mblsha/retrobus-explorer/README.md

# RetroBus Explorer

RetroBus Explorer is an FPGA-based platform designed to capture, analyze, and
visualize signals from legacy 5V system buses. It uses a specialized
level-shifting interface board for bus compatibility, streams the captured data
through an FT600 FTDI chip, and presents live waveforms, decoded protocols, and
analytics via a Marimo Notebook interface in the browser.

## Start here: Sharp organizer cards

- **Dump a card or program its SRAM:** [card dumper and SRAM programmer](gateware/projects/sharp-organizer-probe/README.md#quick-start).
- **Emulate a card and run native IQ-7000/OZ experiments:** [ROM/SRAM2 emulator and eval-loop quick start](gateware/projects/sharp-organizer-emulator/README.md#quick-start), with UART control and bidirectional FT600 streaming.
- **Observe an organizer's bus:** [passive organizer monitor](gateware/projects/sharp-organizer-card/README.md).

See [Choose an organizer tool](gateware/README.md#choose-an-organizer-tool) for
the fixture and bus role of each project. The emulator's
[qualification record](gateware/projects/sharp-organizer-emulator/QUALIFICATION.md)
separates verified simulation/build results from pending organizer tests.

# Current Status

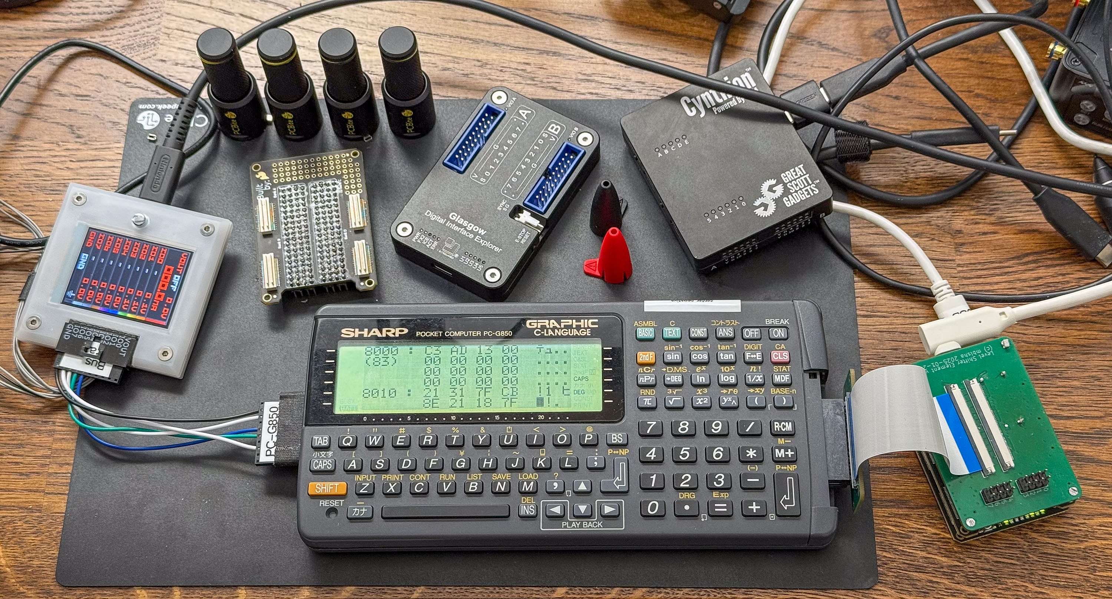
[picture p1: _images/pc-g850.jpg]
SHARP PC-G850 with both its UART and System Bus connected to a computer


* SHARP PC-G850 (Z80-based)

    **Bus Decoding**: Works

    **Visualization**:

     * SED1560 LCD controller: Basic functionality works
     * Key Matrix: Works (decodes key scanning with IO ports)

    **ROM Decoding**: In Progress ([Binary Ninja
    Plugin](https://github.com/mblsha/Z80/blob/master/SharpPCG850View.py))

    **External ROM Emulation**: Can stream data in ext banks 0 and 1 from USB3
    continuously, this could be used for video playback

* SHARP IQ-7000 (SC62015-based)

    **ROM Decoding**: In Progress ([Binary Ninja
    Plugin](https://github.com/mblsha/binja-esr))

    **Card Emulation / Native Eval Loop**: [Spade implementation with UART and FT600](gateware/projects/sharp-organizer-emulator/README.md#quick-start); organizer launch and electrical timing await qualification. Intended for the IQ-7000-style bus and OZ family, including OZ-9600 experiments.

# Sharp organizer card dumping and SRAM programming

With the Alchitry Au1, Level Shifter Element, and Sharp Organizer Host Adapter,
RetroBus Explorer can dump card ROM and SRAM, deduplicate identical data while
preserving each tested pin selection, and write confirmed SRAM banks.
`capture-card` commits the current backup to a Git archive before reversible
SRAM presence probes; `write-sram` checks that backup and verifies the write.
The CLI automatically releases the bus when an operation ends.

Start with the [card dumper and SRAM programmer quick start](gateware/projects/sharp-organizer-probe/README.md#quick-start)
for hardware requirements, capture commands, archive storage, and SRAM writes.
The archive location is supplied by the caller with `--archive-dir`.

# Sharp organizer native execution card

The [native execution card quick start](gateware/projects/sharp-organizer-emulator/README.md#quick-start)
provides a resident eval loop, UART-loaded code and SRAM2 scratch memory,
live bus timing controls, and bidirectional FT600 bus traces and host-fed data.
Simulation and nextpnr builds are verified; organizer boot entry still needs
hardware qualification. See the [CLI command reference](gateware/projects/sharp-organizer-emulator/README.md#cli-command-reference)
for image loading, native jobs, SRAM2 access, timing, capture, and explicit disarm.

# Hardware

Project is built on top of [Alchitry Au FPGA board](https://www.sparkfun.com/alchitry-au-fpga-development-board-xilinx-artix-7.html) and [Ft Element board](https://www.sparkfun.com/alchitry-ft-element-board.html).
To interface with the 5V bus, a Level Shifter Element board is used.

For streaming capture projects such as the SHARP PC-G850 bus monitor and the
SHARP PC-E500 card monitor, the expected host data path is the Alchitry Ft
Element USB3 FIFO interface (FT600-class device) driven through the repository's
`py/d3xx` wrapper. The Au board's onboard USB-UART remains the control/console
path and is not the expected bulk capture interface.

Hardware adapters connect the Level Shifter Element board to the target system.
Up to 48 signals can be captured simultaneously.

Up to two adapters can be connected at the same time, allowing to capture
communication on the system bus and the external bus card.

# Hardware Adapters (up to 48 signals)

* [Level Shifter Element Au1](https://github.com/mblsha/retrobus-explorer/blob/master/jitx/alchitry-au1-level-shifter.stanza)
* [Pin Tester](https://github.com/mblsha/retrobus-explorer/blob/master/jitx/pin-tester.stanza) to test correctness and signal integrity
* [SHARP PC-G850 Bus Connector](https://github.com/mblsha/retrobus-explorer/blob/master/jitx/sharp-pc-g850-bus.stanza)
* [SHARP PC-E500 RAM Card](https://github.com/mblsha/retrobus-explorer/blob/master/jitx/sharp-pc-e500-ram-card.stanza)
* [SHARP Organizer Card](https://github.com/mblsha/retrobus-explorer/blob/master/jitx/sharp-organizer-card.stanza) (plugs into organizers)
* [SHARP Organizer Host](https://github.com/mblsha/retrobus-explorer/blob/master/jitx/sharp-organizer-host.stanza) (accepts card connections)
* [SC62015 CPU Interposer](https://github.com/mblsha/retrobus-explorer/blob/master/jitx/sharp-sc62015-interposer.stanza)
* [SC61860 CPU Interposer](https://github.com/mblsha/retrobus-explorer/blob/master/jitx/sharp-sc61860-interposer.stanza)

# Misc Adapters

* [RPi 40-pin to RPi Pico](https://github.com/mblsha/retrobus-explorer/blob/master/jitx/rpi-pico-40-pin-adapter.stanza)
* [Saleae to DSLab probes](https://github.com/mblsha/retrobus-explorer/blob/master/jitx/saleae-dslab-adapter.stanza)

# Building FPGA Projects

The active FPGA gateware is written in Spade and lives in the `gateware/` uv
workspace. Swim compiles each project to SystemVerilog; Cocotb and Verilator
provide the local behavioral test path.

## Quick Start

```bash
cd gateware

# First-time Python/testbench setup
uv sync --locked --all-packages

# Validate the registered workspace and run a project testbench
uv run python tools/project_inventory.py --check
uv run python tools/run_tb.py --project projects/pin-tester
```

See the [gateware guide](gateware/README.md) for the project layout, shared
components, waveform generation, constraint handling, synthesis, and flashing.

# License

* PCB Design Files
All PCB design files are distributed under the
`CERN Open Hardware Licence Version 2 – Permissive`.

* Software (HDL, JS, etc.)
Other than the d3xx Python code all other repository contents—including FPGA
gateware (HDL), and Python code are released under the `Apache License 2.0`.

You are free to use, modify, and distribute both portions of this project under
their respective terms.

# Alternatives

* [LAIR](https://github.com/MustBeArt/LAIR) project shows how to decode Z80
    bus using a hardware adapter with propagation delays that connects to a
    136-channel HP Agilent 1670G logic analyzer.

# USB Device Info

* Alchitry Au

  Product ID: 0x6010
  Vendor ID:  0x0403  (Future Technology Devices International Limited)

* Alchitry Ft

  Name: FTDI SuperSpeed-FIFO Bridge
  Product ID: 0x601e
  Vendor ID:  0x0403  (Future Technology Devices International Limited)

# Thanks

A big thank you (in alphabetical order) to Louis, Nikolai, and
[Peter](https://taricorp.net) for teaching me the dark magic of hardware and
low-level development, as well as for patiently answering my countless
questions. This project would not exist without your help.
