mblsha/retrobus-explorer/py/d3xx/README.md

This version has minor changes to find the dynamic d3xx library.

Requires https://ftdichip.com/drivers/d3xx-drivers/ to be located in this
directory.

## Organizer emulator streaming

The [Sharp organizer ROM/SRAM2 emulator](../../gateware/projects/sharp-organizer-emulator/README.md#ft600-capture-and-host-fed-streams)
uses these bindings for buffered bus capture and concurrent host-to-FPGA data.
Its guide covers exact device selection, binary capture, offline decoding,
receive backpressure, and throughput limits. UART carries emulator control.

# License

This software is provided by Future Technology Devices International Limited “as
is” and any express or implied warranties, including, but not limited to, the
implied warranties of merchantability and fitness for a particular purpose are
disclaimed. In no event shall future technology devices international limited be
liable for any direct, indirect, incidental, special, exemplary, or
consequential damages (including, but not limited to, procurement of substitute
goods or services; loss of use, data, or profits; or business interruption)
however caused and on any theory of liability, whether in contract, strict
liability, or tort (including negligence or otherwise) arising in any way out of
the use of this software, even if advised of the possibility of such damage.
