mblsha/retrobus-explorer/jitx-py/sharp-sc61860-interposer/README.md

# sharp-sc61860-interposer

Python JITX port scaffold for the SHARP SC61860 interposer board.

This is a thin two-layer polyimide flex PCB using the shared JLCPCB 0.11 mm FPC process defaults.
