mblsha/retrobus-explorer/jitx-py/sharp-sc62015-interposer/README.md

# sharp-sc62015-interposer

Python JITX port scaffold for the SHARP SC62015 interposer board.

This is a thin two-layer polyimide flex PCB using the shared JLCPCB 0.11 mm FPC process defaults.
