mblsha/retrobus-explorer/jitx-py/alchitry-au1-level-shifter/README.md

# alchitry-au1-level-shifter

Python JITX port scaffold for the Alchitry Au1 level shifter board.
