mblsha/retrobus-explorer/jitx-py/sharp-organizer-host/README.md

# sharp-organizer-host-py

Python JITX port scaffold for the retrobus `sharp-organizer-host` board.
