mblsha/retrobus-explorer/gateware/projects/sharp-pc-e500-card/FPGA_PROTOCOL.md

# PC-E500 FPGA Protocol Reference

This document describes the PC-E500 card FPGA control surface:

- USB-UART commands exposed by the FPGA
- Special CE6 control-page registers handled by the FPGA
- Saleae debug and bus-capture streams
- FT600 bulk capture of sampled-bus words
- Response formats and practical examples

All timings below assume the current `100 MHz` FPGA clock.

## Overview

The design exposes two separate control paths:

- USB-UART command parser
  - direct host control for RAM, ROM, timing, and measurement dump
- CE6 special control page
  - calculator-visible write-only registers in the CE6 card-ROM region

Optional bulk capture is exposed separately:

- FT600 sampled-bus stream
  - exact mirror of the `saleae[4]` sampled-bus words
  - enabled by CE6 control-page configuration
  - active whenever any enabled FT source is active
  - current sources:
    - measurement window
    - USB-UART latch

Normal CE1 RAM and CE6 ROM timing uses the shared `tNN` delay.
CE6 control-page writes use the separate `cNN` delay.

## Saleae Debug Streams

The Saleae header exposes raw bus pins plus several FPGA-generated debug streams.

Current line map:

| Line | Signal | Meaning |
| --- | --- | --- |
| `saleae[0]` | `ce1` | raw CE1 pin |
| `saleae[1]` | `ce6` | raw CE6 pin, active low |
| `saleae[2]` | `rw` | raw R/W pin |
| `saleae[3]` | event stream | compact CE event stream |
| `saleae[4]` | sampled bus stream | late-sampled address/data/status stream |
| `saleae[5]` | address pulse | debounced internal address-change pulse |
| `saleae[6]` | data UART | settled data-change stream |
| `saleae[7]` | address UART | settled address-change stream |

### Framing

The Saleae UART-like streams are not the same as the `1,000,000 baud` USB-UART.

- `saleae[3]`, `saleae[4]`, `saleae[6]`, and `saleae[7]` run at `100,000,000 baud`
- FPGA clock is `100 MHz`, so one serial bit lasts one FPGA cycle = `10 ns`
- framing is:
  - `1` start bit, low
  - `N` data bits, `LSB` first
  - `1` stop bit, high
  - no parity

Important decode rule:

- do not decode these as ordinary `8N1` bytes unless the payload width is actually `8`
- `saleae[3]` is one `16`-bit frame
- `saleae[4]` is one `32`-bit frame
- `saleae[6]` is one `8`-bit frame
- `saleae[7]` is one `18`-bit frame

For `saleae[3]` and `saleae[4]`, a single event is one wide UART frame, not a sequence of little-endian bytes.

### `saleae[3]` Event Stream

`saleae[3]` emits one `16`-bit event word per classified CE event:

```text
bits 15:8  event tag
bits  7:0  data byte
```

Tags:

| Tag | Meaning |
| --- | --- |
| `0x52` | CE1 read |
| `0x57` | CE1 write |
| `0x72` | CE6 read |
| `0x77` | CE6 write |

Example:

```text
0x575A
```

means a CE1 write carrying data byte `0x5A`.

### `saleae[4]` Sampled Bus Stream

`saleae[4]` emits one `32`-bit sampled bus word. The sampler fires from either:

- an external `cycle_start` pulse, or
- the internal debounced address-change trigger

After either a real `cycle_start` or an internal address-change trigger seeds a
sample, the FPGA may continue emitting phase-locked synthetic follow-up samples
at the nominal `1310 ns` cycle time even if no new trigger arrives. Follow-ups
stop after the captured phase has timed out, which is currently about `64`
nominal cycles (`~83.8 us`) without a new `cycle_start` or address-change
trigger.

Word layout:

```text
bits 17:0   addr
bits 25:18  data
bits 31:26  status
```

Status bit layout:

| Bit | Name | Meaning |
| --- | --- | --- |
| `0` | `rw` | sampled raw `R/W` pin |
| `1` | `ce1_active` | normalized CE1-active flag |
| `2` | `ce6_active` | normalized CE6-active flag |
| `3` | `synthetic_followup` | `1` if this sample is a phase-locked synthetic follow-up event |
| `4` | `from_cycle_start` | `1` if sample was armed by external `cycle_start` |
| `5` | `ctrl_range` | `1` if CE6 was active and low16 was in `0xFFF0..0xFFFF` |

Decode formulas:

```text
addr   =  word        & 0x3FFFF
data   = (word >> 18) & 0xFF
status = (word >> 26) & 0x3F
```

Example:

```text
word = 0x044311F0
addr = 0x311F0
data = 0x10
status = 0x01
```

`status = 0x01` means:

- `rw = 1`
- `ce1_active = 0`
- `ce6_active = 0`
- `synthetic_followup = 0`
- `from_cycle_start = 0`
- `ctrl_range = 0`

So this sample came from the address-change path, not CE1/CE6-qualified decode, and captured address `0x311F0` with data `0x10`.

### `saleae[5]` Address Pulse

`saleae[5]` is not a UART. It is a one-bit pulse stream that marks the
internal debounced address-change trigger.

Properties:

- it pulses on the first observed address change
- it then waits about `100 ns` before re-arming
- it is useful as a correlation marker for the sampled bus stream on `saleae[4]`
- it is upstream of the settled address UART on `saleae[7]`

## USB-UART Commands

The USB-UART runs at `1,000,000 baud`, `8N1`.

Each command must be terminated by `CR` or `CRLF`.
The FPGA echoes accepted input, then emits a response line.

### RAM Commands

These access the `2 KiB` CE1 RAM backing store.

| Command | Meaning |
| --- | --- |
| `rAAA` | Read RAM offset `0x000..0x7FF` |
| `wAAA=BB` | Write RAM offset `0x000..0x7FF` |

Rules:

- `AAA` is 3 hex digits
- `BB` is 2 hex digits
- RAM is only `2 KiB`, mirrored across the larger CE1 window

Examples:

```text
r123
123=5A
```

```text
w123=5A
OK
```

### ROM Commands

These access the `2 KiB` CE6 ROM backing store.

| Command | Meaning |
| --- | --- |
| `RAAA` | Read ROM offset `0x000..0x7FF` |
| `WAAA=BB` | Write ROM offset `0x000..0x7FF` |

Rules:

- `AAA` is 3 hex digits
- `BB` is 2 hex digits
- This writes the FPGA ROM backing store directly
- Calculator bus writes to CE6 do not program ROM; only `WAAA=BB` does

Examples:

```text
W021=A7
OK
R021
021=A7
```

### Timing Commands

| Command | Meaning | Default |
| --- | --- | --- |
| `tNN` | Set normal CE1/CE6 memory classify delay | `t45` |
| `cNN` | Set CE6 control-page write delay | `c03` |

Rules:

- `NN` is decimal `00..99`
- unit is `10 ns`

Examples:

```text
t45
T=450ns
```

```text
c03
C=030ns
```

What they control:

- `tNN`
  - CE1 RAM read/write classify timing
  - CE6 ROM read classify timing
- `cNN`
  - CE6 control-page writes in low16 `0xFFF0..0xFFFF`

### FT Commands

These control the USB-UART FT source latch and query FT stream state.

| Command | Meaning |
| --- | --- |
| `F0` | clear the USB-UART FT source latch |
| `F1` | set the USB-UART FT source latch |
| `F?` | print FT stream status |

Rules:

- `F0` and `F1` only affect the UART source latch
- FT sampled-bus capture runs when any enabled FT source is active
- the USB-UART source only contributes to capture if `FT_STREAM_CFG.bit1 = 1`
- if the UART source is cleared or disabled, the current UART-session overflow
  count is frozen until the next `F1`

`F0` and `F1` response:

```text
OK
```

`F?` response:

```text
FS,CFG=..,MODE=..,UART=0,WIN=0,CAP=0,SOVF=........,OVF=........
```

Fields:

- `CFG`
  - current `FT_STREAM_CFG` source mask
- `MODE`
  - current `FT_STREAM_MODE` behavior mask
- `UART`
  - `1` if the USB-UART FT source latch is currently set
- `WIN`
  - `1` if the measurement-window FT source is currently active
- `CAP`
  - `1` if FT sampled-bus capture is currently active after OR-ing enabled sources
- `SOVF`
  - dropped FT sampled-bus words counted in the current or most recent UART
    session, where `F1` starts a new session baseline
- `OVF`
  - cumulative FT sampled-bus words dropped because the FT capture FIFO was full

### Measurement Commands

These dump measurement reports created by CE6 control-page writes.

| Command | Meaning |
| --- | --- |
| `m` | Dump all queued measurement reports |
| `m?` | Print measurement FIFO status |
| `m!` | Clear queued reports and reset overflow count |

`m?` response:

```text
MS,CNT=..,OVF=........,ARM=0
```

Fields:

- `CNT`
  - queued report count
- `OVF`
  - number of reports dropped because the report FIFO was full
- `ARM`
  - `1` if a measurement interval is currently armed

`m` response:

```text
MR,S=..,E=..,TK=........,EV=........,AU=........,FO=........
...
MEND
```

Fields:

- `S`
  - start tag byte
- `E`
  - stop tag byte
- `TK`
  - elapsed FPGA ticks at `100 MHz`
  - convert to time with `ns = TK * 10`
- `EV`
  - CE event count delta
- `AU`
  - address-UART emission count delta
- `FO`
  - FT sampled-bus words dropped because the FT capture FIFO was full

`m!` response:

```text
OK
```

## CE6 Special Control Page

The FPGA treats CE6 low16 `0xFFF0..0xFFFF` as a special write-only control page.

Important properties:

- CE6 is active when `low`
- address decode uses only the low 16 bits
- reads from this page are passive
  - the FPGA does not drive the data bus
- writes to this page use the separate `cNN` delay
  - not `tNN`

Because low16 decoding is used, both aliases match:

- `0x0FFF0..0x0FFFF`
- `0x1FFF0..0x1FFFF`

From calculator software, use the logical CE6 addresses in the `0x01xxxx` range.

### Register Map

| Logical address | Low16 | Name | Access | Meaning |
| --- | --- | --- | --- | --- |
| `0x01FFF0` | `0xFFF0` | `MARK_START` | write-only | arm measurement and snapshot counters |
| `0x01FFF1` | `0xFFF1` | `ECHO` | write-only | send written byte to USB-UART |
| `0x01FFF2` | `0xFFF2` | `MARK_STOP` | write-only | stop measurement and queue report |
| `0x01FFF3` | `0xFFF3` | `MARK_ABORT` | write-only | clear armed measurement without report |
| `0x01FFF4` | `0xFFF4` | `FT_STREAM_CFG` | write-only | configure FT sampled-bus capture sources |
| `0x01FFF5` | `0xFFF5` | `FT_STREAM_MODE` | write-only | configure FT capture behavior |
| `0x01FFF6..0x01FFFF` | `0xFFF6..0xFFFF` | reserved | write-only | currently no action |

### `ECHO` Register

Writing a byte to `0x01FFF1` sends that byte directly to the FPGA USB-UART.

Example calculator-side use:

```basic
POKE &H1FFF1,65
```

Expected host output:

```text
A
```

If the USB-UART is busy when the byte arrives:

- the byte is dropped
- the FPGA later prints:

```text
!OVERRUN
```

### Measurement Registers

The measurement path is meant for profiling instruction timing and bus activity.

#### `MARK_START`

Write a tag byte to `0x01FFF0`.

Effect:

- arms the profiler
- snapshots:
  - current tick counter
  - current CE event count
  - current address-UART count

The baseline is taken after the start marker's same-cycle bookkeeping, so the interval starts after the marker write itself.

#### `MARK_STOP`

Write a tag byte to `0x01FFF2`.

Effect:

- if armed, computes deltas from the stored baseline
- enqueues one report in the report FIFO
- clears `ARM`

#### `MARK_ABORT`

Write any byte to `0x01FFF3`.

Effect:

- clears `ARM`
- does not enqueue a report

### `FT_STREAM_CFG`

Write a config byte to `0x01FFF4`.

Bit layout:

```text
bit 0     enable measurement-window FT source
bit 1     enable USB-UART-latch FT source
bits 7:2  reserved
```

Rules:

- `bit0 = 1`
  - the measurement window contributes to FT sampled-bus capture
- `bit1 = 1`
  - the USB-UART FT latch contributes to FT sampled-bus capture
- FT sampled-bus capture is active when any enabled source is active
- `bit1 = 0`
  - clears the USB-UART FT latch
  - ends the current UART overflow session
- `FT_STREAM_CFG = 0`
  - disables all FT sampled-bus capture sources
  - clears the USB-UART FT latch
- reads from this register are passive like the rest of the control page
- reserved bits are currently ignored

### `FT_STREAM_MODE`

Write a mode byte to `0x01FFF5`.

Bit layout:

```text
bit 0     hold measurement-source policy sampled at MARK_START
bits 7:1  reserved
```

Rules:

- `bit0 = 0`
  - while the measurement window is armed, the measurement FT source follows the
    live `FT_STREAM_CFG.bit0` value
- `bit0 = 1`
  - `MARK_START` snapshots whether `FT_STREAM_CFG.bit0` was enabled and holds
    that policy until `MARK_STOP` / `MARK_ABORT`
- reads from this register are passive like the rest of the control page
- reserved bits are currently ignored

When enabled, the FT stream carries the exact `saleae[4]` sampled-bus words:

- one sampled-bus word is `32` bits
- FT600 transport emits the low `16` bits first, then the high `16` bits
- the measurement `MARK_START` write itself is not part of the measurement-window FT source
- `MARK_STOP` and `MARK_ABORT` close the measurement-window FT source before their own
  control-page writes are considered for FT capture

If the dedicated FT capture FIFO fills:

- new FT sampled-bus words are dropped
- bus sampling continues
- dropped-word count is reported in the measurement result as `FO`

### Measurement Example

Calculator-side:

```basic
POKE &H1FFF0,1
REM code under test
POKE &H1FFF2,2
```

Host-side:

```text
m
MR,S=01,E=02,TK=0000002D,EV=00000005,AU=00000003,FO=00000000
MEND
```

Interpretation:

- start tag `0x01`
- stop tag `0x02`
- elapsed time `0x2D` ticks = `45 * 10 ns = 450 ns`
- `5` CE events
- `3` address-UART emissions
- `0` dropped FT sampled-bus words

## Error and Busy Responses

Common FPGA USB-UART responses:

| Response | Meaning |
| --- | --- |
| `OK` | command accepted |
| `BUSY` | command collided with active internal work and was not completed |
| `ERR` | parse or syntax error |
| `!OVERRUN` | CE6 `ECHO` byte was dropped because USB-UART output was busy |

## Practical Notes

### RAM and ROM Sizes

- CE1 RAM backing store: `2 KiB`
- CE6 ROM backing store: `2 KiB`
  - low16 `0x0000..0x07FF` only
  - reads above that range remain passive

### CE6 ROM vs CE6 Control Page

These are different mechanisms:

- CE6 ROM low window:
  - read-backed from FPGA ROM storage
  - programmed over USB-UART with `R/W`
- CE6 control page `0xFFF0..0xFFFF`:
  - write-only special registers
  - separate `cNN` timing
  - not normal ROM

### Low16 Aliasing

For CE6:

- ROM low-window decode uses low16 bits
- control-page decode uses low16 bits

So these pairs alias internally:

- `0x10000` and low16 `0x0000`
- `0x1FFF1` and low16 `0xFFF1`

For calculator-side code, prefer the logical `0x01xxxx` addresses.
