mblsha/retrobus-explorer/gateware/projects/ethernet-diagnostic/QUALIFICATION.md

# Qualification provenance

## The qualified bitstreams predate the Spade v0.20.0 upgrade

Every bitstream named in this file, including the hardware-qualified H700
build at `build/microsd-ddr-ethernet-h700`, was compiled by **Spade v0.17.0**
from a source revision at or before `ae2a4b7`. The sources have since moved to
**Spade v0.20.0**, and the shared library no longer depends on `nstd`.

That upgrade was made without changing any top-level port list, any
`#[no_mangle]` module name, or any reset, clock-domain, high-impedance or
timing semantics, and the generated SystemVerilog was compared module by
module at each step. It is still a **different netlist**: v0.20.0 emits
`microsd-emulator` in 274 modules where v0.17.0 emitted 336, and every
internal net is named differently.

So a bitstream rebuilt from the current sources is not this bitstream. Place
and route would start from a different netlist, which means a fresh
placement-seed search (`tools/search_placement_seeds.py`) and a fresh timing
check before any seed could be called usable, and then the full hardware
campaign again before it could replace the qualified build. Seed 19's
65.78/64 MHz and 80.38/80 MHz margins say nothing about what a new netlist
would route to. Until that work is done, treat `build/microsd-ddr-ethernet-h700`
as the only qualified artifact and leave it alone; a measurement taken against
a rebuilt card is a measurement about a different card.

## nextpnr 0.9.7 H700 candidate, 2026-09-25

`--profile h700-rg35xx` rebuilt from Spade v0.20.0 sources with patched
nextpnr-xilinx 0.9.7, into `build/microsd-ddr-ethernet-h700-np097`. Seed 19
misses `fclk` on this netlist (63.18/64 MHz); of seeds 1-32 only **seed 6**
passed every clock and the direct-output check: `fclk` 76.92/64 MHz, `dclk`
81.77/80 MHz, 838,659 verified configuration bits, bitstream SHA-256
`dfb5fccd813399e01ee82b62fe78d57ff53ecd4c6068f236415057e37bca0a75`.
The qualified seed-19 build was not touched and remains the qualified card.

Measured on the RG35XX Plus with the `linux-consoles` job-runner image
(`4389c576…`, `--card-max-hz 6000000`), unattended under the lab lease:

- Deploy uploaded all 268,288 sectors with windowed readback; the card
  reported the file's SHA-256. The 34 host tests passed.
- Fifteen cold starts: thirteen reached userspace, median 5.75 s (5.72-5.81),
  card clock 6.00 MHz, 0-3 invalid command frames per boot (10 in total). The
  other two were 25-second windows the host did not start in for 20.6 and 24.7
  seconds; both served U-Boot without error until the window closed, and every
  45-second window reached userspace.
- Job 28 (six awake windows, a 256 MiB md5 each) ended `done exit=0` with all
  eight stages and its output returned through the debug partition.
- Same-day control on the qualified seed-19 card: five of five reached
  userspace, median 5.76 s (5.73-5.79), 0-1 invalid frames (2 in total).

Before Ethernet was connected, UART-loader builds from the same sources with
`--sd-pullups --sd-io-clock-hz 64000000`, seed 6, built once with 0.9.7 and
once with 0.9.4, passed full BIST and behaved identically across four
alternating cold starts on an SPL-only 64 KiB prefix (12.001 MHz 1 ms peak,
then a 201.2 kHz idle clock). The UART top ignores `--h700-mmc` and
`--slow-mmc`, and its loader baud scales with the SD fabric clock (640 kbaud
at 64 MHz).

Not repeated for this candidate: the GKD full-memory stress, filesystem and
bulk-download campaign above, which needs the GKD host.

## Current revision qualification, 2026-09-14

Functional source `ae2a4b7` was built and programmed on the Arty A7-35T.
The exact seed-12 bitstream SHA-256 was
`fcf2845175b3ee4a7c82ea7fb4a0c2ebb821f331c2e818445375bf6f4c8794ea`.
The normal patched-nextpnr 0.9.4 builder reported fabric 108.96/100 MHz and
DDR 85.30/80 MHz; both MII clocks, the IDELAY clock, all 18 Gray-pointer paths,
five direct SD outputs, native FIFO register storage, negative-edge timing, and
675,769 decoded configuration bits passed their checks.

Local validation included 33 host tests and 20 CDC-fixture tests, each normally
and under `python -O`. All six Ethernet Spade/Verilator configurations passed
(13 test cases), including the independent READ-while-armed status, sequence,
reply-cache, and no-memory-effect scenario. The builder's 43 support tests also
passed.

The exact bitstream passed the primary integrated hardware campaign:

- A 64 KiB upload and bulk readback matched with zero retries. Armed network
  READ and WRITE returned status 4. A bounded SD write/read run passed with zero
  controller errors; after detachment and DISARM, Ethernet returned the exact
  GKD-written prefix.
- Full 256 MiB SD stress passed: a 59.18-second sequential write, three complete
  readbacks (63.40, 63.12, and 63.24 seconds), and two rounds of 1,024 random
  updates with neighbor checks. MMC error counters stayed zero and the monitor
  observed no unexpected kernel messages.
- The independent final SD-pattern hash matched a complete Ethernet download:
  268,435,456 bytes in 23.81 seconds, 90.21 Mbps validated payload, with three
  recovered requests. Concurrent Ethernet liveness was 300/300 pings.
- FAT16 format, write, rename, delete, read-only remount/hash, and three
  `fsck.fat -n` checks passed. Three cold programming cycles each reached JTAG
  DONE, responded over Ethernet, completed a fresh verified upload, and
  enumerated/read correctly on the GKD with zero MMC error counters.

A later restore operation exposed a physical-link qualification failure. During
the restore readback the GKD repeatedly re-enumerated the card and eventually
reported one block I/O error. A clean controller detach/rebind allowed complete
readback of the restored image, but re-enumeration continued and invalidated the
strict clock/kernel-log monitor. Requesting 10 MHz did not eliminate it because
each re-enumeration reset the host to the CSD's 13 MHz limit. This late behavior
means the current physical setup is **not qualified as continuously reliable at
13 MHz**, despite the earlier clean full-memory campaign. It is consistent with
the known signal-integrity sensitivity and was not accompanied by memory
corruption.

The original 256 MiB image was restored and independently matched through both
the GKD and a final complete Ethernet read:
`585d9bfb6ae030cc9917ca4d5d731d91dd15c71416a569520721a007165b2779`.
The final Ethernet read took 23.95 seconds with eight recovered requests. The
FPGA was left programmed and disarmed; the GKD external controller was left
unbound to stop repeated card cycling. Generated logs, images, and bitstreams
remain local outside Git.

## Hardware-qualified integration, 2026-09-14

Hardware qualification used the implementation at `805c5f7` on an Arty A7-35T,
JD bottom-header adapter with common ground, and the GKD external SD host at
12,913,043 Hz actual, four-bit. The AX88179B negotiated 100 Mbps full duplex.

Programmed bitstream SHA-256:
`a0e0b2bc5069a6ad743efd48dd867911aaea7e5a9665224c09fec1393f32735f`

The normal builder repeated seed 4 with an identical synthesized netlist,
FASM, frames, and 670,797 decoded configuration bits. Its bitstream SHA-256 was
`939c6e5b83b14bf64e17e3c92085a36bc220c6cb6674e748908d2ff4f61db176`;
the only four differing bytes were in the `.bit` timestamp header. The decoded
configuration listing SHA-256 was
`b84553ae8415f6414515b87a62975add45dcfaa5247c6745d822e731fb1a2084`.

Build: local Yosys 0.68+ and patched nextpnr-xilinx 0.9.4, seed 4. The combined
build uses ABC9 register-aware mapping and the shared native-DDR register
stage. Fabric timing reached 103.61 MHz against 100 MHz; DDR reached 83.47 MHz
against 80 MHz. Both 25 MHz MII domains and 200 MHz IDELAY passed. All 18
registered Gray-pointer crossings, five direct SD output checks, native FIFO
register-storage checks, and bitstream round-trip verification passed.

- All six Ethernet Spade/Verilator configurations passed, including SD
  read/write and stalled-write ownership. Sixteen host/benchmark tests passed
  normally and under optimized Python; all 33 DDR support tests passed.
- A 64 KiB Ethernet upload/readback, 4 KiB SD modification, and Ethernet
  download matched byte-for-byte. Armed Ethernet reads and writes returned
  refusal status 4. Unwritten neighboring and final DDR pages stayed unchanged.
- Full 256 MiB SD write: 58.87 seconds. Three complete readbacks took
  63.15, 63.36, and 63.43 seconds. Two rounds of 256 random updates and their
  neighboring-block checks passed. MMC error counters stayed zero, with no
  recovery or unexpected kernel messages. Concurrent ping: 300/300 replies.
- Full 256 MiB Ethernet download: 23.91 seconds, 89.83 Mbps validated payload,
  seven recovered requests. Its hash matched the independently generated SD
  pattern: `89858a9d846127d37009eb9ef53554d90e7aa8ed0581f696f31586bb8b62d1e0`.
- Three 4 MiB bulk reads, window 10: 89.25, 90.84, and 90.84 Mbps, with
  two, one, and one recovered requests. Odd-LBA and final-sector reads passed.
- FAT16 format, write/rename/delete, read-only remount/hash checks, and
  `fsck.fat -n` passed. The filesystem was unmounted afterward.

The original 256 MiB image was backed up before programming and restored after
qualification. Complete SD and Ethernet readbacks matched the backup. Restoring
the partition table produced the expected `mmcblk1: p1` discovery message, which
the strict raw-transfer monitor flagged; an additional full read-only
qualification then passed with zero errors and no new kernel messages. The card
was left armed, bound to the GKD at the settings above, and unmounted.

The installed nextpnr binary on the qualification Mac was linked against Boost
1.90. Its build invocation needed
`DYLD_LIBRARY_PATH=/opt/homebrew/Cellar/boost/1.90.0/lib` because the current
Homebrew default was 1.92; this was scoped to the command, not set globally.

These are measured application payload rates; recovered UDP requests are
included in elapsed time. They do not describe upload throughput. Generated
build outputs, raw images, and test logs are retained locally, not in Git.

## Bulk-read image, 2026-09-09

Bitstream SHA-256:
`7f8a21dad8f7640e431d3fbb15c032c8f80f0ffbd6d9094842fd962afd7ae89a`

Setup: Arty A7-35T; JD bottom-header adapter with common ground; GKD external
SD host at 12,913,043 Hz actual, four-bit; direct AX88179B 100 Mbps full duplex.
Placement seed 4 passed 100 MHz fabric and 80 MHz DDR timing; 18 registered
Gray-pointer crossings passed the routed-delay check.

- Three 4 MiB downloads, window 10: 90.32–91.38 Mbps validated image payload.
- Complete 256 MiB Ethernet download: 90.70 Mbps, 23.68 seconds, 20 recovered
  requests, hash matched the independently SD-written pattern.
- After host-client cleanup, another complete read: 90.54 Mbps, 23.72 seconds,
  17 recovered requests, SHA-256
  `89858a9d846127d37009eb9ef53554d90e7aa8ed0581f696f31586bb8b62d1e0`.
- Full 256 MiB SD write, three full readbacks, and 512 mixed updates passed
  with zero controller errors or unexpected kernel messages.
- Odd-LBA and final-sector Ethernet checks passed; concurrent ping: 300/300.

The calculated downstream wire use was about 99 Mbps, including framing.
This was not a direct wire capture. Window 16 increased retries and reduced
throughput. Writes remain single-sector ordered operations; these download
rates do not describe uploads.

These results are transcribed from the local development archive at commit
`f993db1be03baefa37b5dc3eac61ffe2704d5625`, file
`gateware/docs/hardware/arty-ethernet-bulk-2026-09-09.json`.
That archive is not part of this PR; generated reports and bitstreams are not
copied into the source tree.

## Earlier cross-interface qualification

Bitstream SHA-256:
`7523d5a909da1e442e8939b3326a372f22f3095fde9ec448c002bfa98053548f`

A 64 KiB Ethernet upload and complete readback, 4 KiB SD modification, and
Ethernet download matched the expected bytes. Full-memory SD stress and FAT16
write/rename/delete/remount/fsck checks passed. Armed network writes and
conflicting retries were rejected; identical retries recovered lost replies.

The same local archive contains the cross-interface record at
`gateware/docs/hardware/arty-ethernet-sd-2026-09-09.json`.

## Requalifying a new image

Record the new `result.json` and bitstream hash, then follow the README's
small-image round trip and the DDR guide's full-memory and filesystem checks.
Measure bulk downloads only after safe detachment/disarm, with an independent
expected image hash. Retain retry counts and MMC qualification output, and
restore arm/bind/clock settings afterward. Never attribute these historical
measurements to a changed bitstream without repeating the hardware checks.
