mblsha/retrobus-explorer/jitx-py/retrobus-jitx-parts/README.md

# retrobus-jitx-parts

Shared reusable JITX Python parts for the `jitx-py` board projects.
