mblsha/retrobus-explorer/jitx-py/espi-debug-breakout/README.md

# espi-debug-breakout-py

Python JITX port scaffold for the retrobus `espi-debug-breakout` board.
