mblsha/retrobus-explorer/gateware/pc-g850.srcs/constrs_1/new/arty.xdc

# https://github.com/Digilent/digilent-xdc/blob/master/Arty-A7-35-Master.xdc

## FPGA Configuration I/O Options
set_property CONFIG_VOLTAGE 3.3 [current_design]
set_property CFGBVS VCCO [current_design]

## Board Clock: 100 MHz
set_property -dict {PACKAGE_PIN E3 IOSTANDARD LVCMOS33} [get_ports {clk}];
create_clock -name clk -period 10.00 [get_ports {clk}];

## Switches
set_property -dict { PACKAGE_PIN A8    IOSTANDARD LVCMOS33 } [get_ports { sw[0] }]; #IO_L12N_T1_MRCC_16 Sch=sw[0]
set_property -dict { PACKAGE_PIN C11   IOSTANDARD LVCMOS33 } [get_ports { sw[1] }]; #IO_L13P_T2_MRCC_16 Sch=sw[1]
set_property -dict { PACKAGE_PIN C10   IOSTANDARD LVCMOS33 } [get_ports { sw[2] }]; #IO_L13N_T2_MRCC_16 Sch=sw[2]
set_property -dict { PACKAGE_PIN A10   IOSTANDARD LVCMOS33 } [get_ports { sw[3] }]; #IO_L14P_T2_SRCC_16 Sch=sw[3]

## Buttons
set_property -dict { PACKAGE_PIN D9    IOSTANDARD LVCMOS33 } [get_ports { btn[0] }]; #IO_L6N_T0_VREF_16 Sch=btn[0]
set_property -dict { PACKAGE_PIN C9    IOSTANDARD LVCMOS33 } [get_ports { btn[1] }]; #IO_L11P_T1_SRCC_16 Sch=btn[1]
set_property -dict { PACKAGE_PIN B9    IOSTANDARD LVCMOS33 } [get_ports { btn[2] }]; #IO_L11N_T1_SRCC_16 Sch=btn[2]
set_property -dict { PACKAGE_PIN B8    IOSTANDARD LVCMOS33 } [get_ports { btn[3] }]; #IO_L12P_T1_MRCC_16 Sch=btn[3]

## LEDs
set_property -dict { PACKAGE_PIN H5    IOSTANDARD LVCMOS33 } [get_ports { led[0] }]; #IO_L24N_T3_35 Sch=led[4]
set_property -dict { PACKAGE_PIN J5    IOSTANDARD LVCMOS33 } [get_ports { led[1] }]; #IO_25_35 Sch=led[5]
set_property -dict { PACKAGE_PIN T9    IOSTANDARD LVCMOS33 } [get_ports { led[2] }]; #IO_L24P_T3_A01_D17_14 Sch=led[6]
set_property -dict { PACKAGE_PIN T10   IOSTANDARD LVCMOS33 } [get_ports { led[3] }]; #IO_L24N_T3_A00_D16_14 Sch=led[7]

# ChipKit Outer Digital Header
set_property -dict { PACKAGE_PIN V15   IOSTANDARD LVCMOS33 } [get_ports { saleae[0] }];
set_property -dict { PACKAGE_PIN U16   IOSTANDARD LVCMOS33 } [get_ports { saleae[1] }];
set_property -dict { PACKAGE_PIN P14   IOSTANDARD LVCMOS33 } [get_ports { saleae[2] }];
set_property -dict { PACKAGE_PIN T11   IOSTANDARD LVCMOS33 } [get_ports { saleae[3] }];
set_property -dict { PACKAGE_PIN R12   IOSTANDARD LVCMOS33 } [get_ports { saleae[4] }];
set_property -dict { PACKAGE_PIN T14   IOSTANDARD LVCMOS33 } [get_ports { saleae[5] }];
set_property -dict { PACKAGE_PIN T15   IOSTANDARD LVCMOS33 } [get_ports { saleae[6] }];
set_property -dict { PACKAGE_PIN T16   IOSTANDARD LVCMOS33 } [get_ports { saleae[7] }];

# ChipKit Inner Digital Header
set_property -dict { PACKAGE_PIN U11   IOSTANDARD LVCMOS33 } [get_ports { saleae_gnd[0] }];
set_property -dict { PACKAGE_PIN V16   IOSTANDARD LVCMOS33 } [get_ports { saleae_gnd[1] }];
set_property -dict { PACKAGE_PIN M13   IOSTANDARD LVCMOS33 } [get_ports { saleae_gnd[2] }];
set_property -dict { PACKAGE_PIN R10   IOSTANDARD LVCMOS33 } [get_ports { saleae_gnd[3] }];
set_property -dict { PACKAGE_PIN R11   IOSTANDARD LVCMOS33 } [get_ports { saleae_gnd[4] }];
set_property -dict { PACKAGE_PIN R13   IOSTANDARD LVCMOS33 } [get_ports { saleae_gnd[5] }];
set_property -dict { PACKAGE_PIN R15   IOSTANDARD LVCMOS33 } [get_ports { saleae_gnd[6] }];
set_property -dict { PACKAGE_PIN P15   IOSTANDARD LVCMOS33 } [get_ports { saleae_gnd[7] }];

# Address
#
# JB                JA
# VCC GND 3 2 1 0   VCC GND 3 2 1 0
# VCC GND 7 6 5 4   VCC GND 7 6 5 4
#
# A14 A12 A10 A08   A06 A04 A02 A00
# A15 A13 A11 A09   A07 A05 A03 A01

# Pmod Header JA
set_property -dict { PACKAGE_PIN G13   IOSTANDARD LVCMOS33 } [get_ports { addr[0] }];
set_property -dict { PACKAGE_PIN D13   IOSTANDARD LVCMOS33 } [get_ports { addr[1] }];
set_property -dict { PACKAGE_PIN B11   IOSTANDARD LVCMOS33 } [get_ports { addr[2] }];
set_property -dict { PACKAGE_PIN B18   IOSTANDARD LVCMOS33 } [get_ports { addr[3] }];
set_property -dict { PACKAGE_PIN A11   IOSTANDARD LVCMOS33 } [get_ports { addr[4] }];
set_property -dict { PACKAGE_PIN A18   IOSTANDARD LVCMOS33 } [get_ports { addr[5] }];
set_property -dict { PACKAGE_PIN D12   IOSTANDARD LVCMOS33 } [get_ports { addr[6] }];
set_property -dict { PACKAGE_PIN K16   IOSTANDARD LVCMOS33 } [get_ports { addr[7] }];

# Pmod Header JB
set_property -dict { PACKAGE_PIN E15   IOSTANDARD LVCMOS33 } [get_ports { addr[8] }];
set_property -dict { PACKAGE_PIN J17   IOSTANDARD LVCMOS33 } [get_ports { addr[9] }];
set_property -dict { PACKAGE_PIN E16   IOSTANDARD LVCMOS33 } [get_ports { addr[10] }];
set_property -dict { PACKAGE_PIN J18   IOSTANDARD LVCMOS33 } [get_ports { addr[11] }];
set_property -dict { PACKAGE_PIN D15   IOSTANDARD LVCMOS33 } [get_ports { addr[12] }];
set_property -dict { PACKAGE_PIN K15   IOSTANDARD LVCMOS33 } [get_ports { addr[13] }];
set_property -dict { PACKAGE_PIN C15   IOSTANDARD LVCMOS33 } [get_ports { addr[14] }];
set_property -dict { PACKAGE_PIN J15   IOSTANDARD LVCMOS33 } [get_ports { addr[15] }];

# Data
#
# JC
# VCC GND 3 2 1 0
# VCC GND 7 6 5 4
#
# D6 D4 D2 D0
# D7 D5 D3 D1

# Pmod Header JC
set_property -dict { PACKAGE_PIN U12   IOSTANDARD LVCMOS33 } [get_ports { data[0] }];
set_property -dict { PACKAGE_PIN U14   IOSTANDARD LVCMOS33 } [get_ports { data[1] }];
set_property -dict { PACKAGE_PIN V12   IOSTANDARD LVCMOS33 } [get_ports { data[2] }];
set_property -dict { PACKAGE_PIN V14   IOSTANDARD LVCMOS33 } [get_ports { data[3] }];
set_property -dict { PACKAGE_PIN V10   IOSTANDARD LVCMOS33 } [get_ports { data[4] }];
set_property -dict { PACKAGE_PIN T13   IOSTANDARD LVCMOS33 } [get_ports { data[5] }];
set_property -dict { PACKAGE_PIN V11   IOSTANDARD LVCMOS33 } [get_ports { data[6] }];
set_property -dict { PACKAGE_PIN U13   IOSTANDARD LVCMOS33 } [get_ports { data[7] }];

# Meta
#
# JD
# VCC GND 3 2 1 0
# VCC GND 7 6 5 4
#
# WR WAIT IORQ  M1
# RD INT1 IORST MREQ

# Pmod Header JD
set_property -dict { PACKAGE_PIN D4    IOSTANDARD LVCMOS33 } [get_ports { meta[0] }]; # m1
set_property -dict { PACKAGE_PIN E2    IOSTANDARD LVCMOS33 } [get_ports { meta[1] }]; # mreq
set_property -dict { PACKAGE_PIN D3    IOSTANDARD LVCMOS33 } [get_ports { meta[2] }]; # iorq
set_property -dict { PACKAGE_PIN D2    IOSTANDARD LVCMOS33 } [get_ports { meta[3] }]; # iorst
set_property -dict { PACKAGE_PIN F4    IOSTANDARD LVCMOS33 } [get_ports { meta[4] }]; # wait
set_property -dict { PACKAGE_PIN H2    IOSTANDARD LVCMOS33 } [get_ports { meta[5] }]; # int1
set_property -dict { PACKAGE_PIN F3    IOSTANDARD LVCMOS33 } [get_ports { meta[6] }]; # wr
set_property -dict { PACKAGE_PIN G2    IOSTANDARD LVCMOS33 } [get_ports { meta[7] }]; # rd

# Meta 2
#
# IO10  IO11  IO36  IO37
# CERAM BNK1  CEROM BNK0
set_property -dict { PACKAGE_PIN U17   IOSTANDARD LVCMOS33 } [get_ports { meta[8] }]; # bnk0  / io37
set_property -dict { PACKAGE_PIN U18   IOSTANDARD LVCMOS33 } [get_ports { meta[9] }]; # bnk1  / io11
set_property -dict { PACKAGE_PIN V17   IOSTANDARD LVCMOS33 } [get_ports { meta[10] }]; # ceram2 / io10
set_property -dict { PACKAGE_PIN N14   IOSTANDARD LVCMOS33 } [get_ports { meta[11] }]; # cerom2 / io36

# ChipKit Outer Digital Header
#set_property -dict { PACKAGE_PIN V15   IOSTANDARD LVCMOS33 } [get_ports { ck_io0  }]; #IO_L16P_T2_CSI_B_14          Sch=ck_io[0]
#set_property -dict { PACKAGE_PIN U16   IOSTANDARD LVCMOS33 } [get_ports { ck_io1  }]; #IO_L18P_T2_A12_D28_14        Sch=ck_io[1]
#set_property -dict { PACKAGE_PIN P14   IOSTANDARD LVCMOS33 } [get_ports { ck_io2  }]; #IO_L8N_T1_D12_14             Sch=ck_io[2]
#set_property -dict { PACKAGE_PIN T11   IOSTANDARD LVCMOS33 } [get_ports { ck_io3  }]; #IO_L19P_T3_A10_D26_14        Sch=ck_io[3]
#set_property -dict { PACKAGE_PIN R12   IOSTANDARD LVCMOS33 } [get_ports { ck_io4  }]; #IO_L5P_T0_D06_14             Sch=ck_io[4]
#set_property -dict { PACKAGE_PIN T14   IOSTANDARD LVCMOS33 } [get_ports { ck_io5  }]; #IO_L14P_T2_SRCC_14           Sch=ck_io[5]
#set_property -dict { PACKAGE_PIN T15   IOSTANDARD LVCMOS33 } [get_ports { ck_io6  }]; #IO_L14N_T2_SRCC_14           Sch=ck_io[6]
#set_property -dict { PACKAGE_PIN T16   IOSTANDARD LVCMOS33 } [get_ports { ck_io7  }]; #IO_L15N_T2_DQS_DOUT_CSO_B_14 Sch=ck_io[7]
set_property -dict { PACKAGE_PIN N15   IOSTANDARD LVCMOS33 } [get_ports { ck_io8  }]; #IO_L11P_T1_SRCC_14           Sch=ck_io[8]
set_property -dict { PACKAGE_PIN M16   IOSTANDARD LVCMOS33 } [get_ports { ck_io9  }]; #IO_L10P_T1_D14_14            Sch=ck_io[9]
#set_property -dict { PACKAGE_PIN V17   IOSTANDARD LVCMOS33 } [get_ports { ck_io10 }]; #IO_L18N_T2_A11_D27_14        Sch=ck_io[10]
#set_property -dict { PACKAGE_PIN U18   IOSTANDARD LVCMOS33 } [get_ports { ck_io11 }]; #IO_L17N_T2_A13_D29_14        Sch=ck_io[11]
set_property -dict { PACKAGE_PIN R17   IOSTANDARD LVCMOS33 } [get_ports { ck_io12 }]; #IO_L12N_T1_MRCC_14           Sch=ck_io[12]
set_property -dict { PACKAGE_PIN P17   IOSTANDARD LVCMOS33 } [get_ports { ck_io13 }]; #IO_L12P_T1_MRCC_14           Sch=ck_io[13]

## ChipKit Inner Digital Header
#set_property -dict { PACKAGE_PIN U11   IOSTANDARD LVCMOS33 } [get_ports { ck_io26 }]; #IO_L19N_T3_A09_D25_VREF_14 	Sch=ck_io[26]
#set_property -dict { PACKAGE_PIN V16   IOSTANDARD LVCMOS33 } [get_ports { ck_io27 }]; #IO_L16N_T2_A15_D31_14 		Sch=ck_io[27]
#set_property -dict { PACKAGE_PIN M13   IOSTANDARD LVCMOS33 } [get_ports { ck_io28 }]; #IO_L6N_T0_D08_VREF_14 		Sch=ck_io[28]
#set_property -dict { PACKAGE_PIN R10   IOSTANDARD LVCMOS33 } [get_ports { ck_io29 }]; #IO_25_14 		 			Sch=ck_io[29]
#set_property -dict { PACKAGE_PIN R11   IOSTANDARD LVCMOS33 } [get_ports { ck_io30 }]; #IO_0_14  		 			Sch=ck_io[30]
#set_property -dict { PACKAGE_PIN R13   IOSTANDARD LVCMOS33 } [get_ports { ck_io31 }]; #IO_L5N_T0_D07_14 			Sch=ck_io[31]
#set_property -dict { PACKAGE_PIN R15   IOSTANDARD LVCMOS33 } [get_ports { ck_io32 }]; #IO_L13N_T2_MRCC_14 			Sch=ck_io[32]
#set_property -dict { PACKAGE_PIN P15   IOSTANDARD LVCMOS33 } [get_ports { ck_io33 }]; #IO_L13P_T2_MRCC_14 			Sch=ck_io[33]

set_property -dict { PACKAGE_PIN R16   IOSTANDARD LVCMOS33 } [get_ports { ck_io34 }]; #IO_L15P_T2_DQS_RDWR_B_14 	Sch=ck_io[34]
set_property -dict { PACKAGE_PIN N16   IOSTANDARD LVCMOS33 } [get_ports { ck_io35 }]; #IO_L11N_T1_SRCC_14 			Sch=ck_io[35]
set_property -dict { PACKAGE_PIN N14   IOSTANDARD LVCMOS33 } [get_ports { ck_io36 }]; #IO_L8P_T1_D11_14 			Sch=ck_io[36]
set_property -dict { PACKAGE_PIN U17   IOSTANDARD LVCMOS33 } [get_ports { ck_io37 }]; #IO_L17P_T2_A14_D30_14 		Sch=ck_io[37]
set_property -dict { PACKAGE_PIN T18   IOSTANDARD LVCMOS33 } [get_ports { ck_io38 }]; #IO_L7N_T1_D10_14 			Sch=ck_io[38]
set_property -dict { PACKAGE_PIN R18   IOSTANDARD LVCMOS33 } [get_ports { ck_io39 }]; #IO_L7P_T1_D09_14 			Sch=ck_io[39]
set_property -dict { PACKAGE_PIN P18   IOSTANDARD LVCMOS33 } [get_ports { ck_io40 }]; #IO_L9N_T1_DQS_D13_14 		Sch=ck_io[40]
set_property -dict { PACKAGE_PIN N17   IOSTANDARD LVCMOS33 } [get_ports { ck_io41 }]; #IO_L9P_T1_DQS_14 			Sch=ck_io[41]

# ChipKit SPI
set_property -dict { PACKAGE_PIN G1    IOSTANDARD LVCMOS33 } [get_ports { ck_miso }]; #IO_L17N_T2_35 Sch=ck_miso
set_property -dict { PACKAGE_PIN H1    IOSTANDARD LVCMOS33 } [get_ports { ck_mosi }]; #IO_L17P_T2_35 Sch=ck_mosi
set_property -dict { PACKAGE_PIN F1    IOSTANDARD LVCMOS33 } [get_ports { ck_sck }]; #IO_L18P_T2_35 Sch=ck_sck
set_property -dict { PACKAGE_PIN C1    IOSTANDARD LVCMOS33 } [get_ports { ck_ss }]; #IO_L16N_T2_35 Sch=ck_ss
