mblsha/retrobus-explorer/gateware/projects/microsd-emulator/constraints/pins.xdc

# Arty A7-35T: JD physical GPIO order 1,2,3,4,7,8,9,10. CMD/DAT output enables are gated by validated image arming.
set_property -dict { PACKAGE_PIN E3 IOSTANDARD LVCMOS33 } [get_ports {clk}]
set_property -dict { PACKAGE_PIN C2 IOSTANDARD LVCMOS33 } [get_ports {rst_n}]
set_property -dict { PACKAGE_PIN A9 IOSTANDARD LVCMOS33 } [get_ports {usb_rx}]
set_property -dict { PACKAGE_PIN D10 IOSTANDARD LVCMOS33 } [get_ports {usb_tx}]
set_property -dict { PACKAGE_PIN D4 IOSTANDARD LVCMOS33 } [get_ports {pmod[0]}]
set_property -dict { PACKAGE_PIN D3 IOSTANDARD LVCMOS33 } [get_ports {pmod[1]}]
set_property -dict { PACKAGE_PIN F4 IOSTANDARD LVCMOS33 } [get_ports {pmod[2]}]
set_property -dict { PACKAGE_PIN F3 IOSTANDARD LVCMOS33 } [get_ports {pmod[3]}]
set_property -dict { PACKAGE_PIN E2 IOSTANDARD LVCMOS33 } [get_ports {pmod[4]}]
set_property -dict { PACKAGE_PIN D2 IOSTANDARD LVCMOS33 } [get_ports {pmod[5]}]
set_property -dict { PACKAGE_PIN H2 IOSTANDARD LVCMOS33 } [get_ports {pmod[6]}]
set_property -dict { PACKAGE_PIN G2 IOSTANDARD LVCMOS33 } [get_ports {pmod[7]}]
create_clock -period 10.000 -name sys_clk [get_ports {clk}]
