mblsha/retrobus-explorer/gateware/projects/sharp-pc-e500-card/verilog/card_ram_2k_v.v

module card_ram_2k_v (
    input wire clk,
    input wire [10:0] waddr,
    input wire [7:0] din,
    input wire we,
    input wire [10:0] raddr_bus,
    output wire [7:0] dout_bus,
    input wire [10:0] raddr_uart,
    output wire [7:0] dout_uart
);
    (* ram_style = "distributed" *) reg [7:0] mem [0:2047];
    integer i;

    initial begin
        for (i = 0; i < 2048; i = i + 1) begin
            mem[i] = 8'h00;
        end
    end

    always @(posedge clk) begin
        if (we) begin
            mem[waddr] <= din;
        end
    end

    assign dout_bus = mem[raddr_bus];
    assign dout_uart = mem[raddr_uart];
endmodule
